fweijers/heltec-lora-boatreadings/pics/BOOTschema.jpg

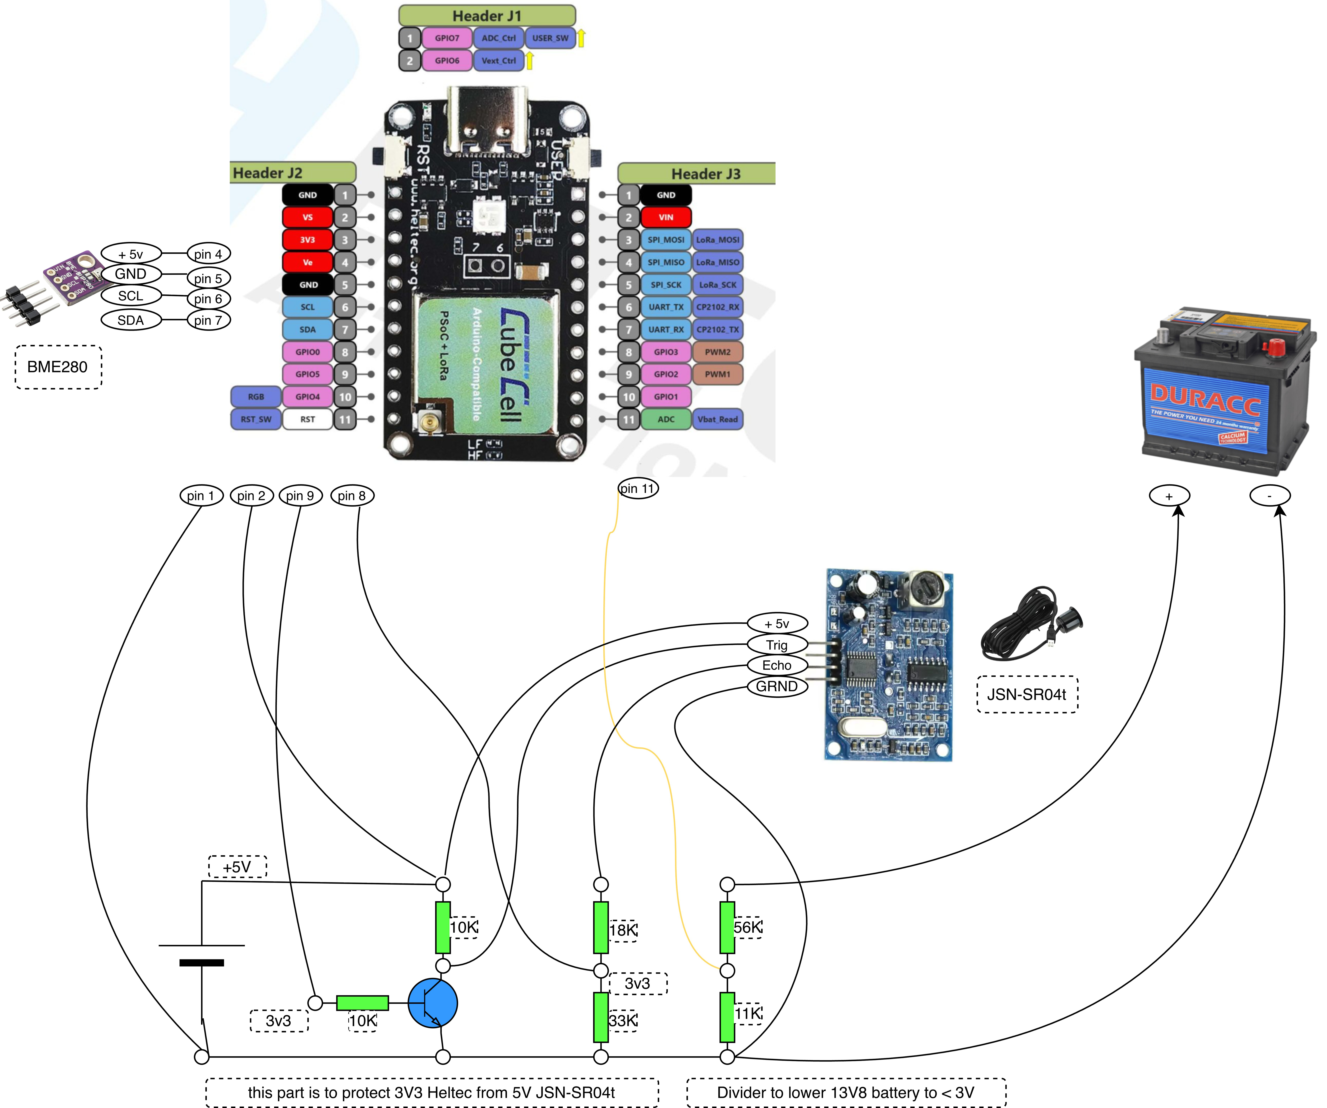
pics/BOOTschema.jpg
