fweijers/heltec-lora-boatreadings/pics/rain.jpg

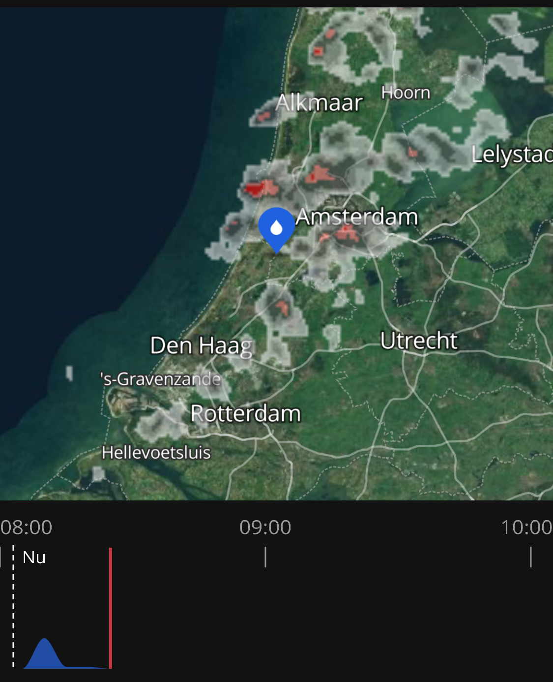
pics/rain.jpg
