fweijers/heltec-lora-boatreadings/pics/SolarController.JPG

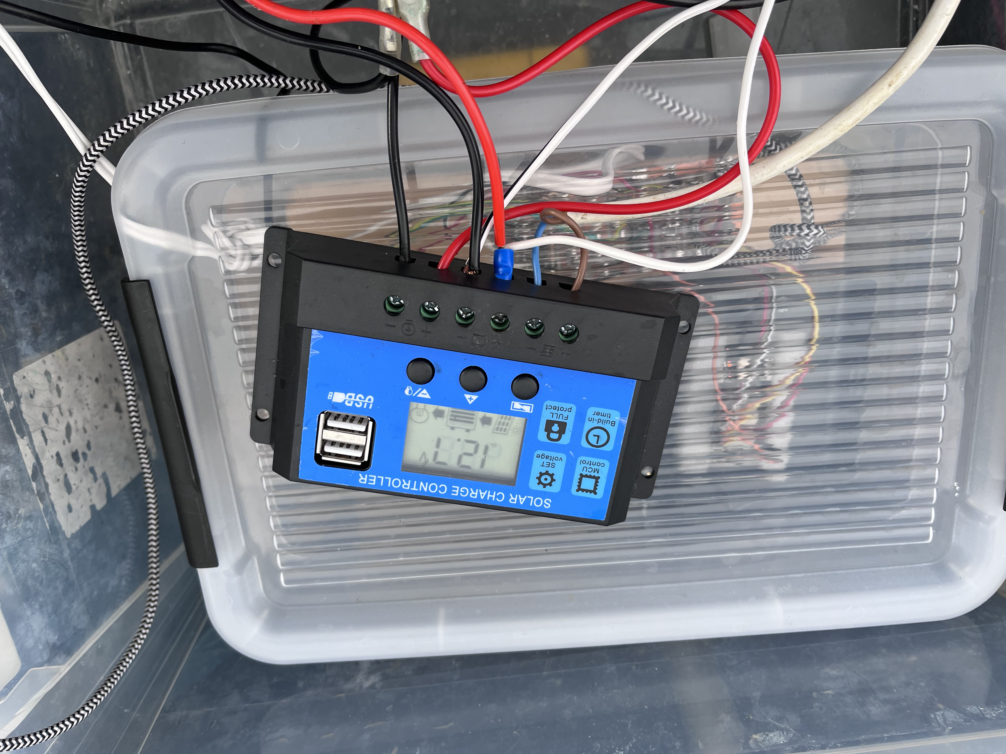
pics/SolarController.JPG
