fweijers/heltec-lora-boatreadings/rain.PNG

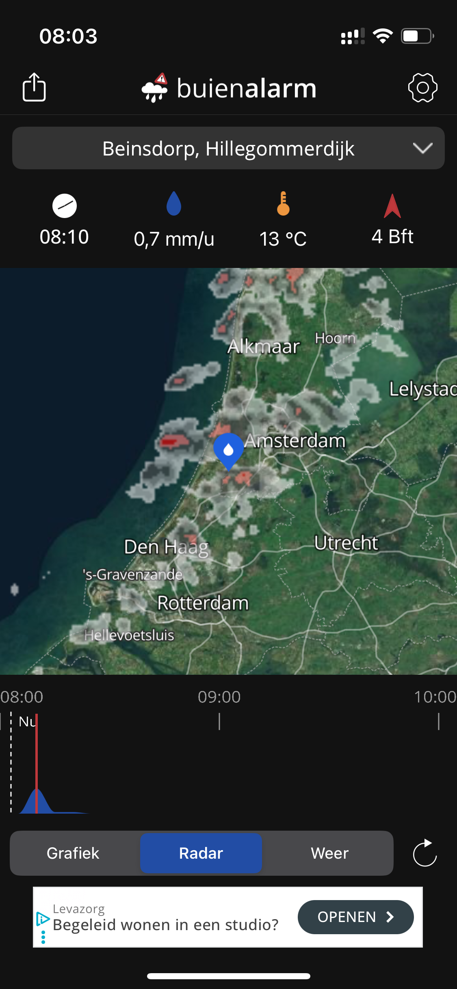
rain.PNG
