fweijers/heltec-lora-boatreadings/pics/CompuInBoat.JPG

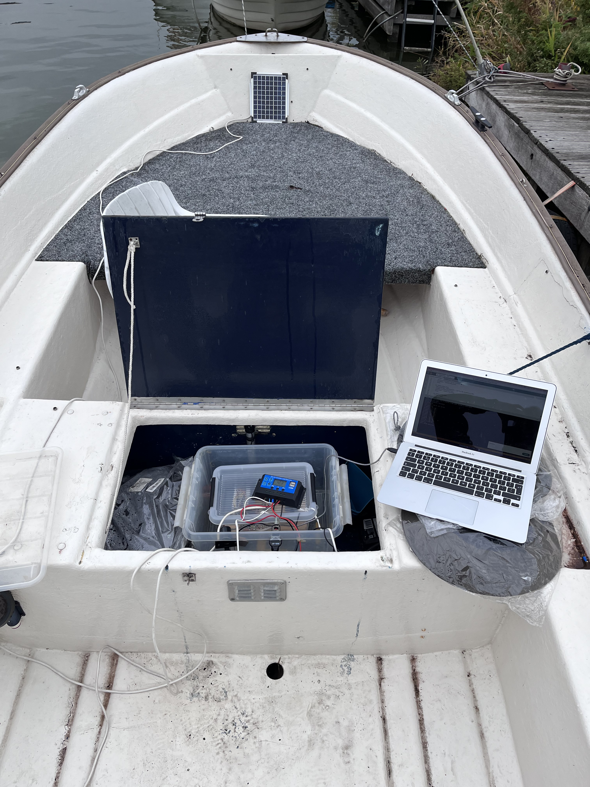
pics/CompuInBoat.JPG
