fweijers/heltec-lora-boatreadings/pics/HeltecInBox.JPG

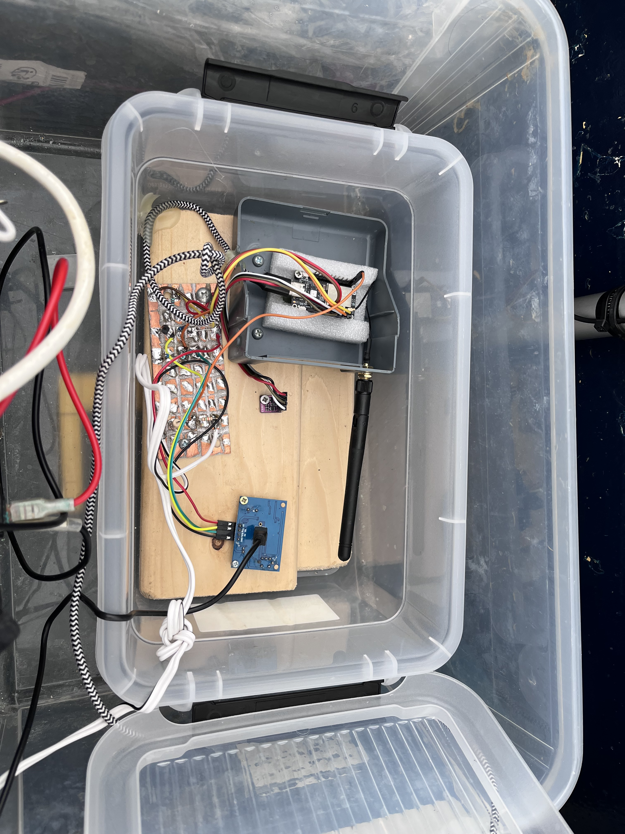
pics/HeltecInBox.JPG
