fweijers/heltec-lora-boatreadings/pics/BilgeMeasurementTube.JPG

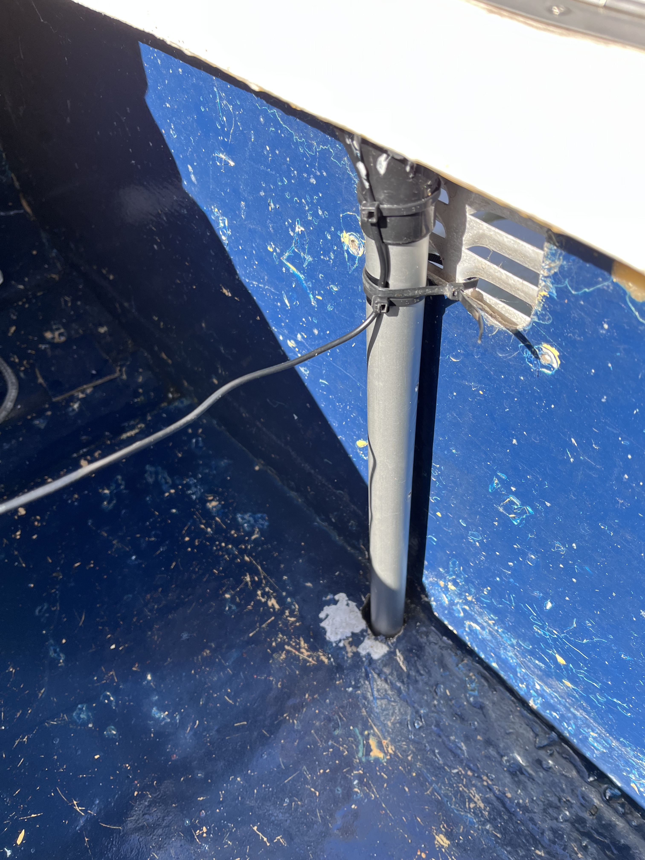
pics/BilgeMeasurementTube.JPG
